ronitnag04/8-bit-computer/Naga V1/Naga V1-04.jpg

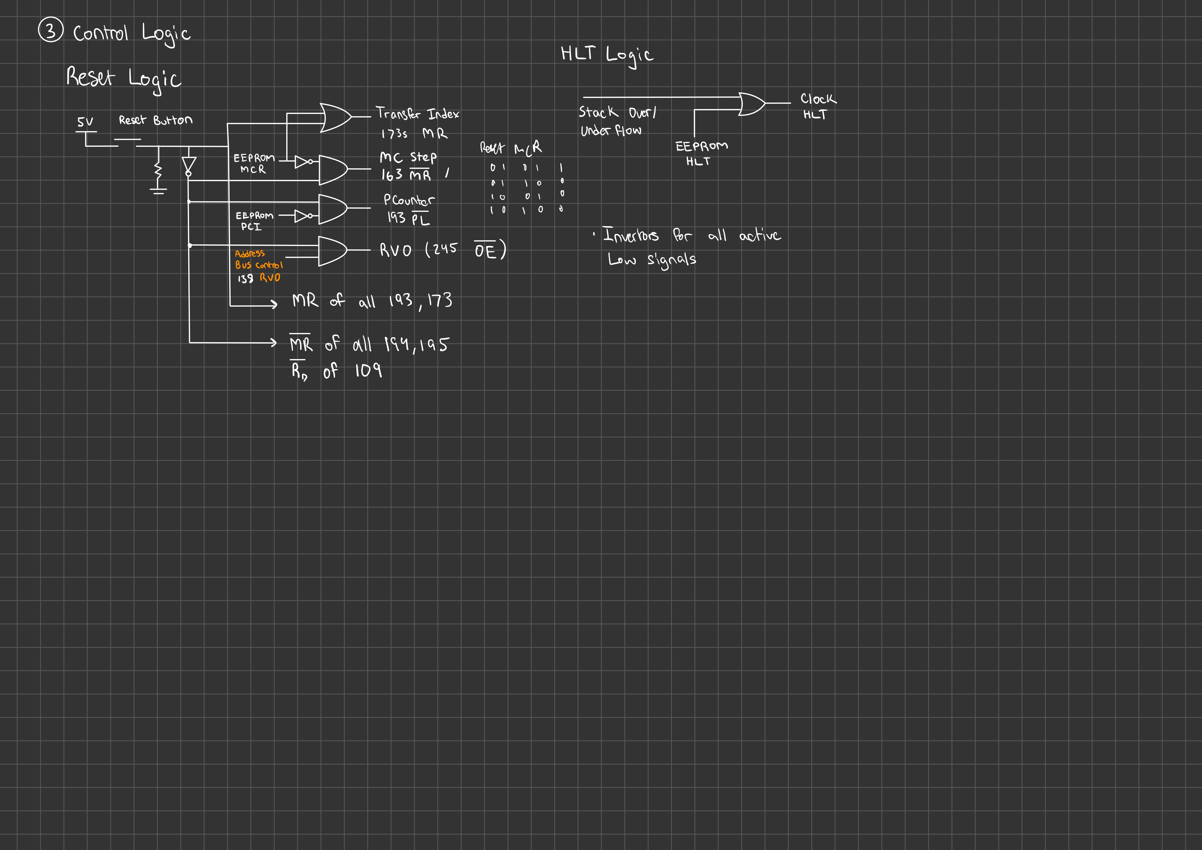
Naga V1/Naga V1-04.jpg
