ronitnag04/8-bit-computer/Naga V1/Naga V1-05.jpg

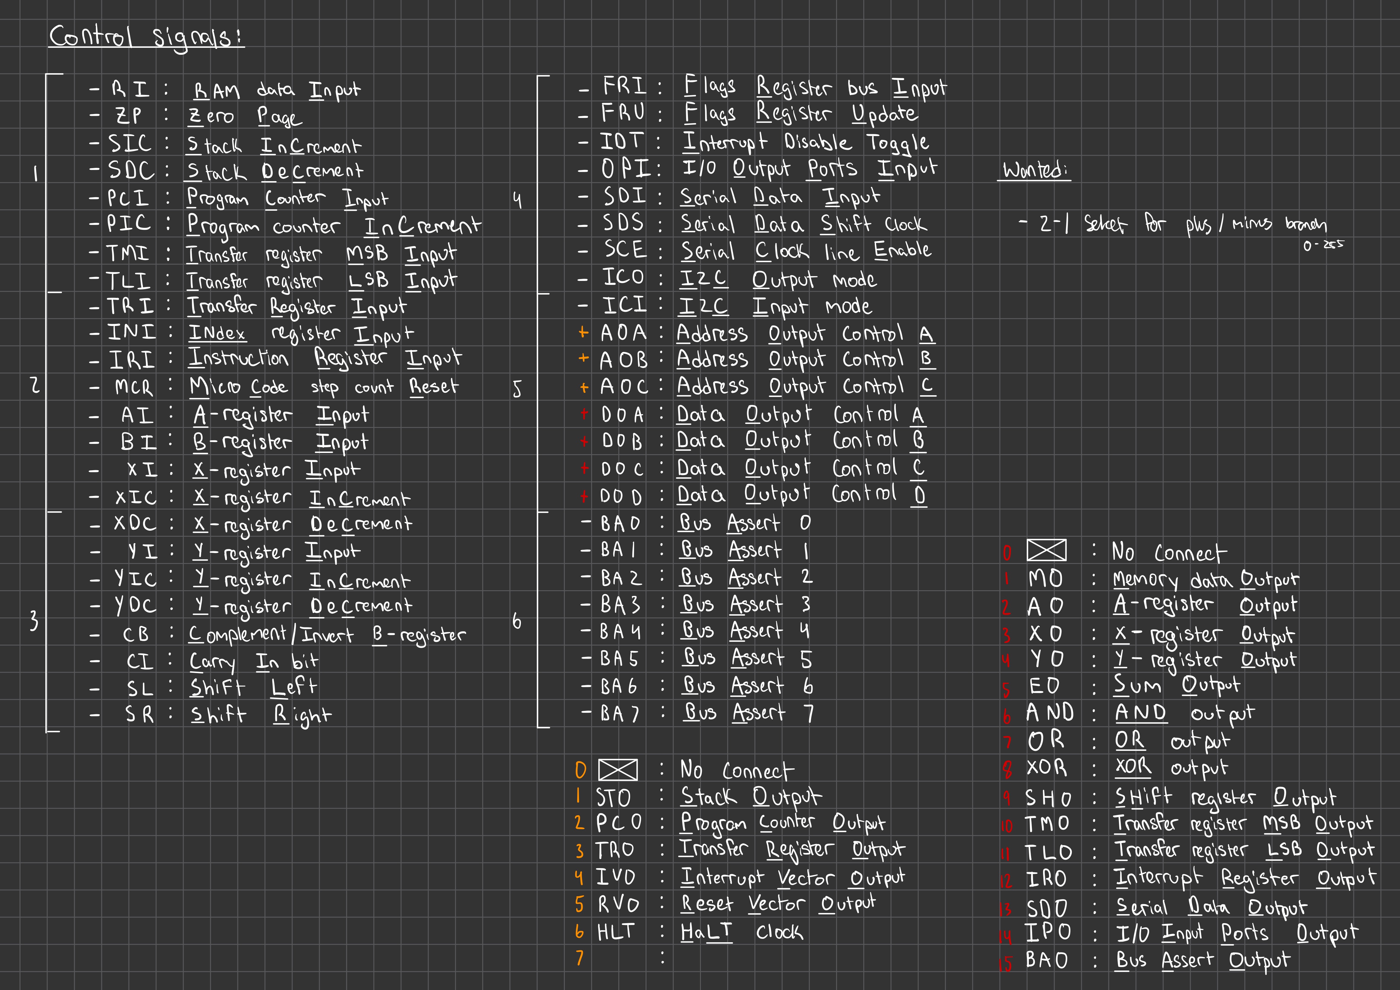
Naga V1/Naga V1-05.jpg
