ronitnag04/8-bit-computer/Naga V1/Naga V1-07.jpg

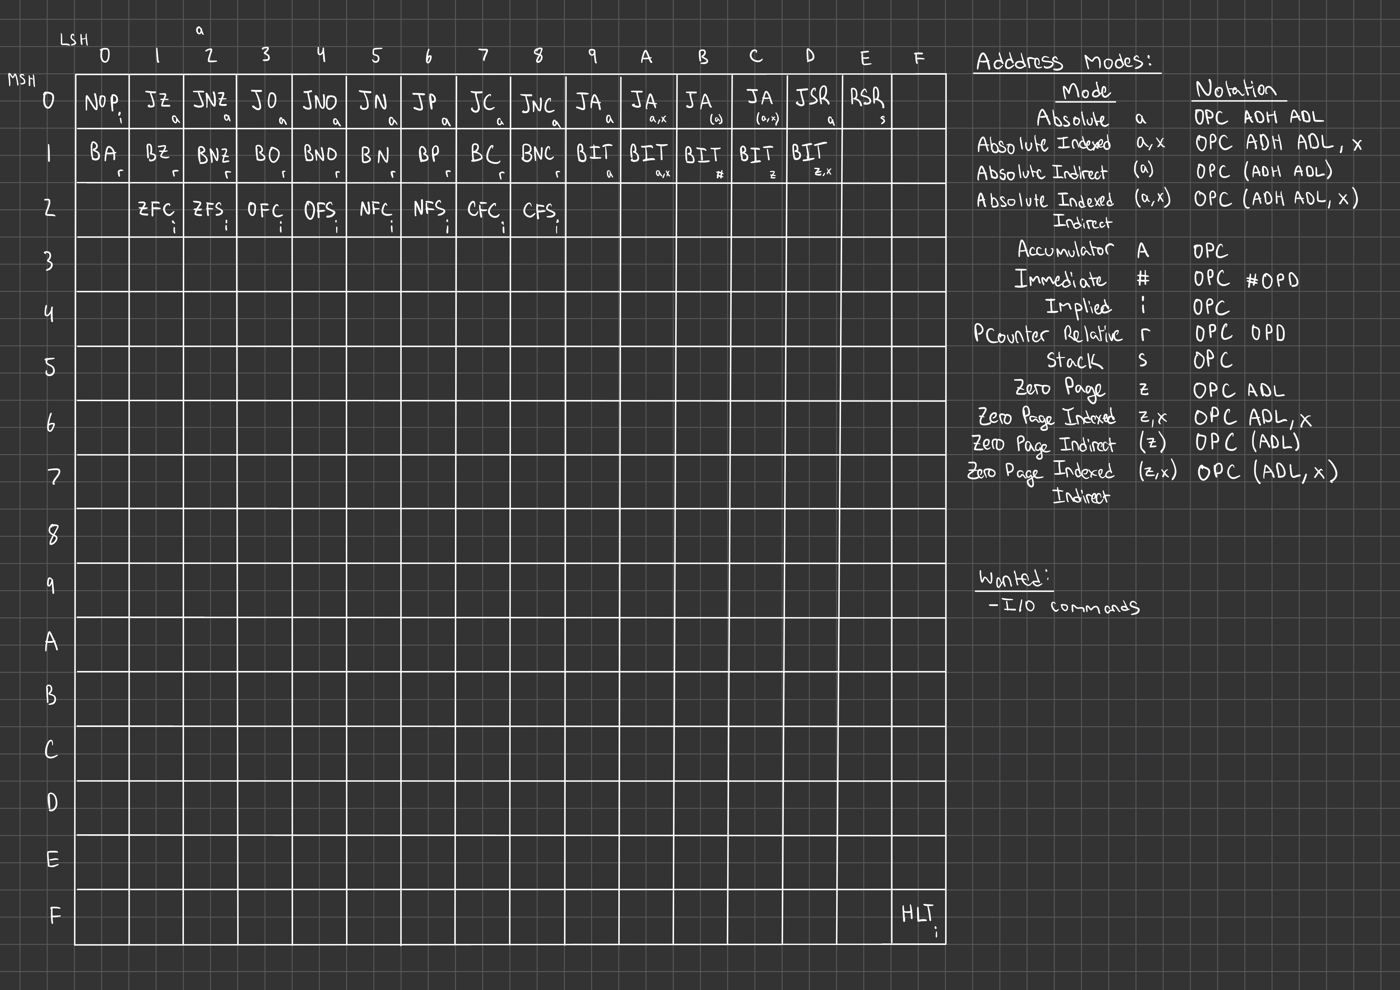
Naga V1/Naga V1-07.jpg
