ronitnag04/8-bit-computer/Naga V1/Naga V1-08.jpg

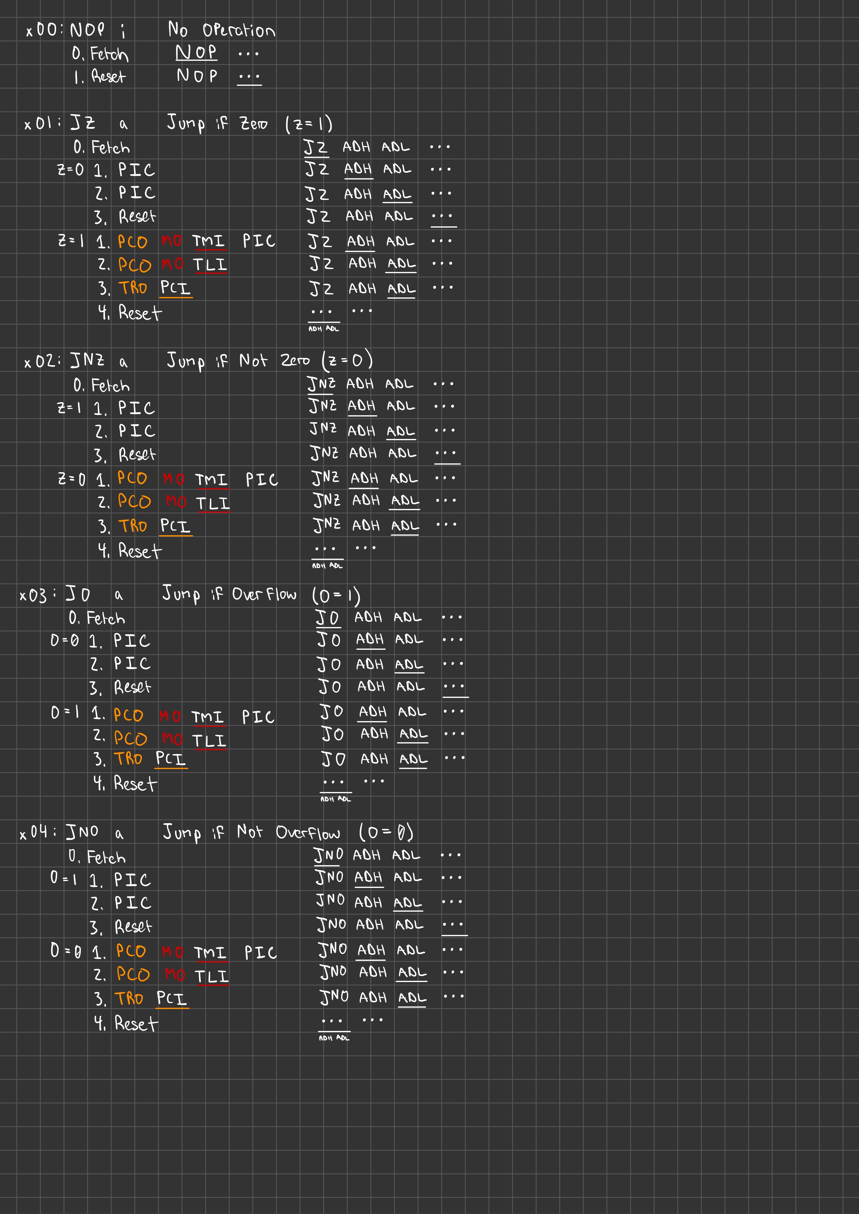
Naga V1/Naga V1-08.jpg
