ronitnag04/8-bit-computer/Naga V1/Naga V1-10.jpg

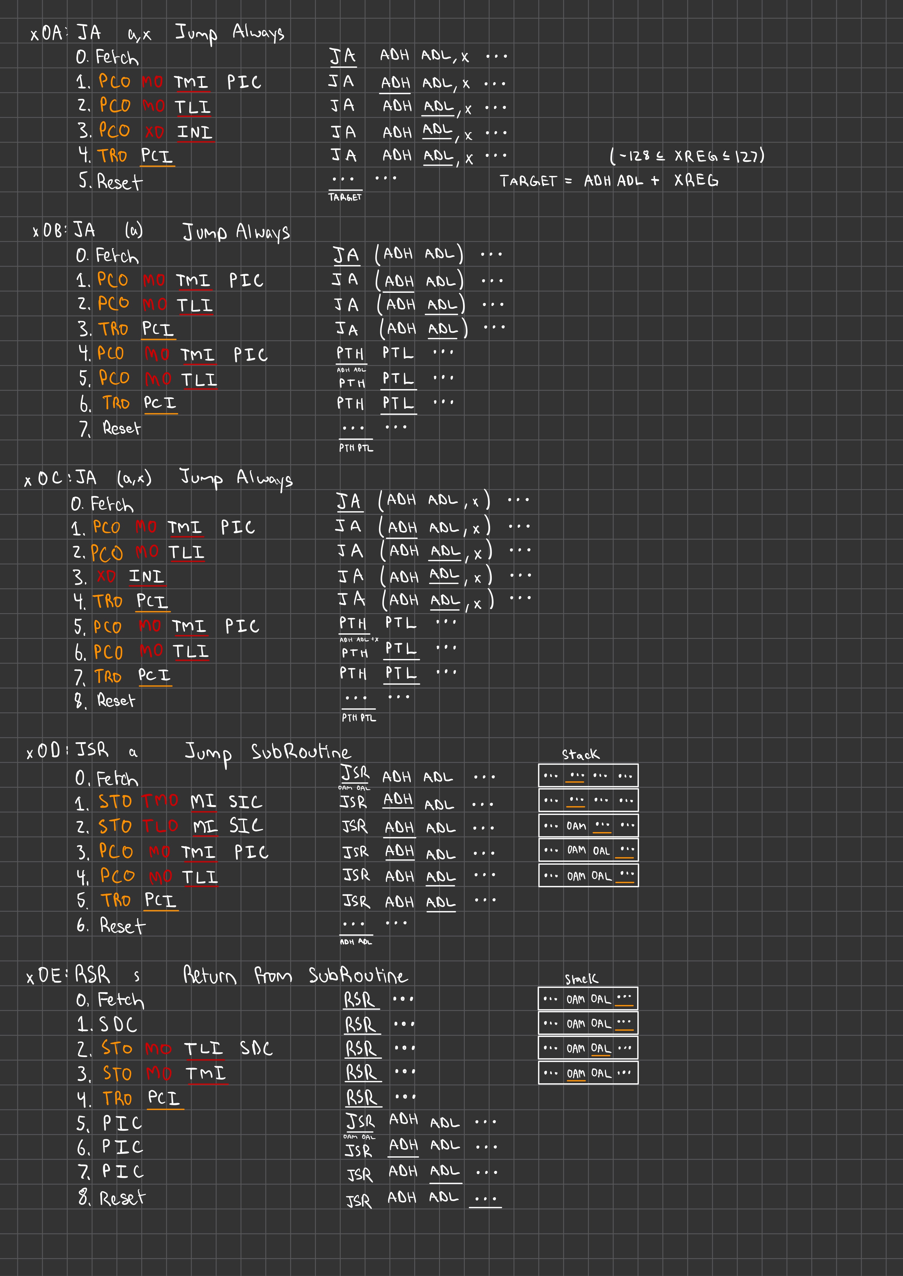
Naga V1/Naga V1-10.jpg
