ronitnag04/8-bit-computer/Naga V1/Naga V1-13.jpg

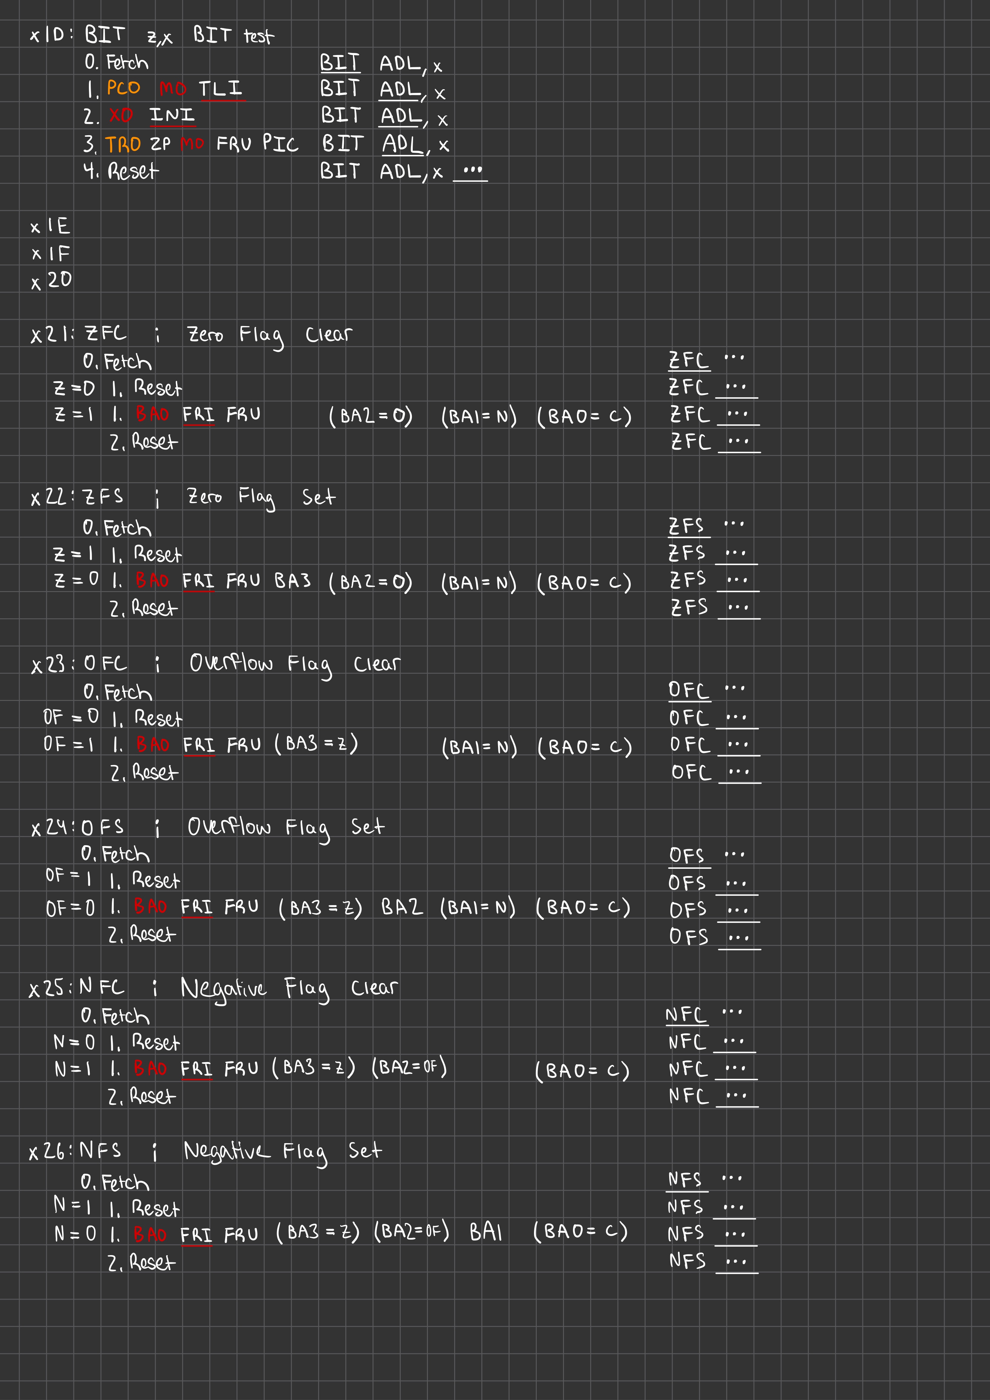
Naga V1/Naga V1-13.jpg
