ronitnag04/8-bit-computer/(commit log)

2023-08-07 Fixed MCR Line issue
    [Control Microcode EEPROM Programmer.ino]
2023-08-07 Analyzed Microcode improvements
    [Improvement Analysis.xlsx]
2023-08-10 Fixed Halt IO Bug
    [Control Microcode EEPROM Programmer.ino]
2023-08-11 Unstable: Developing Flags control
    [Control Microcode EEPROM Programmer.ino]
2023-08-11 Stable: Finished flags control
    [Scripts.xlsx]
2023-08-12 Added Flags testing script
    [Scripts.xlsx]
2023-08-13 Optimized Loop Code LDB once
    [Scripts.xlsx]
